wa1hco/Wideband-LNA/Wideband_LNA_TQP3M9037.jpg

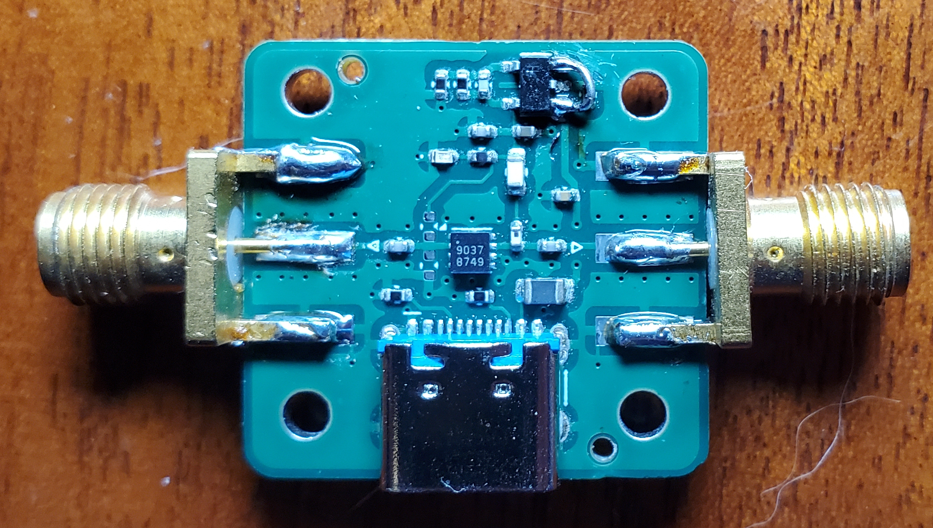
Wideband_LNA_TQP3M9037.jpg
