wa1hco/Wideband-LNA/Wideband LNA board and enclosure.jpg

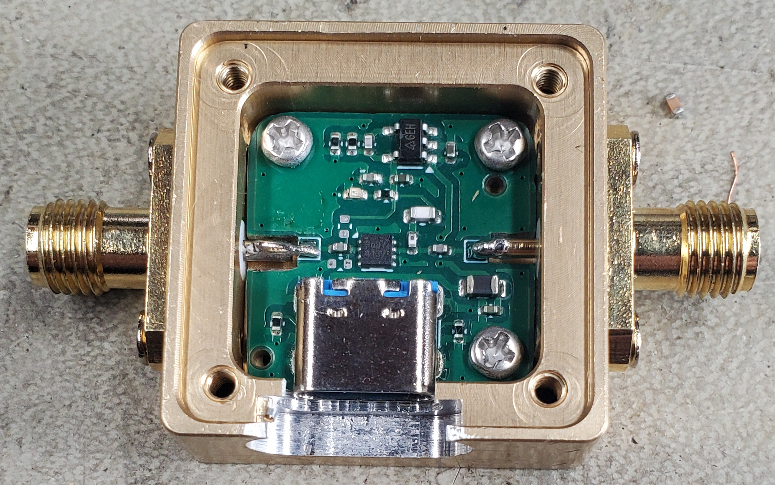
Wideband LNA board and enclosure.jpg
