wa1hco/Wideband-LNA/README.md

# Wideband-LNA
LNA with Qorvo TQP3M9036
~20 dB gain
~0.5 dB noise figure
50 MHz to 2 GHz
~8 dB return loss

Includes bias T option
Power from coax also available on USB-C

Input protection improved with inductor to ground.
