wa1hco/Wideband-LNA/Enclosure_19x19_board.jpg

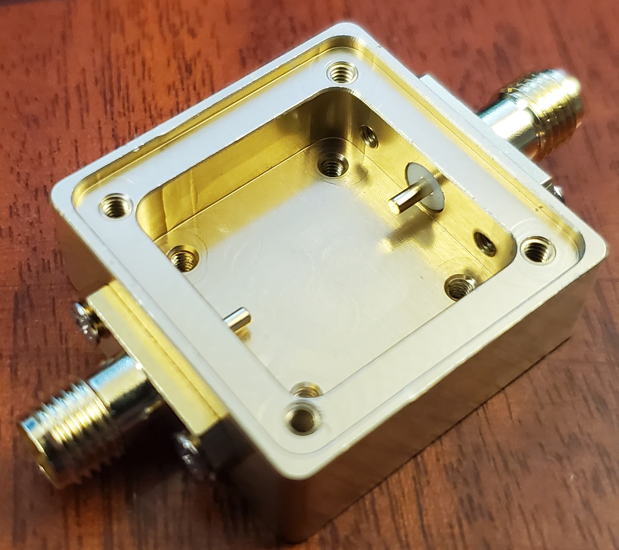
Enclosure_19x19_board.jpg
