wa1hco/Wideband-LNA/test/lna_bench/doc/schematic.png

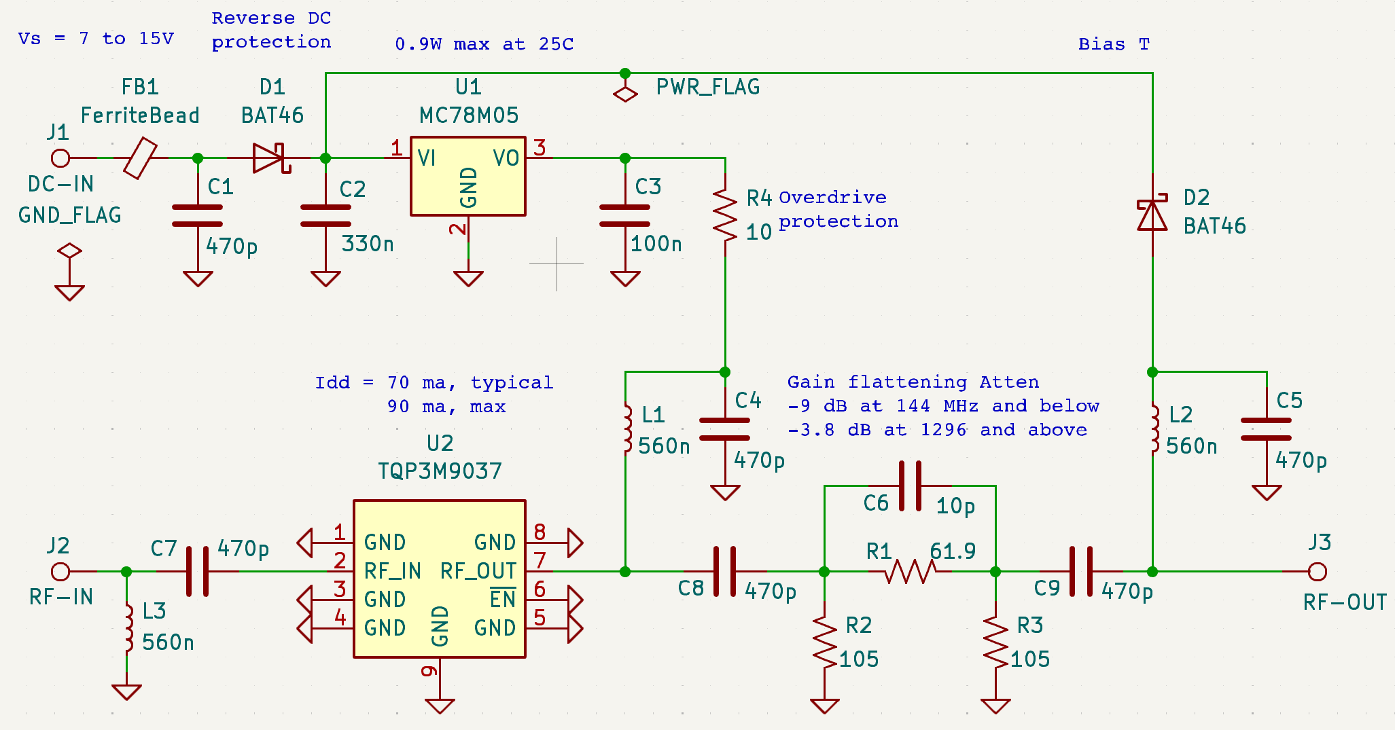
test/lna_bench/doc/schematic.png
