wa1hco/Wideband-LNA/output.pdf

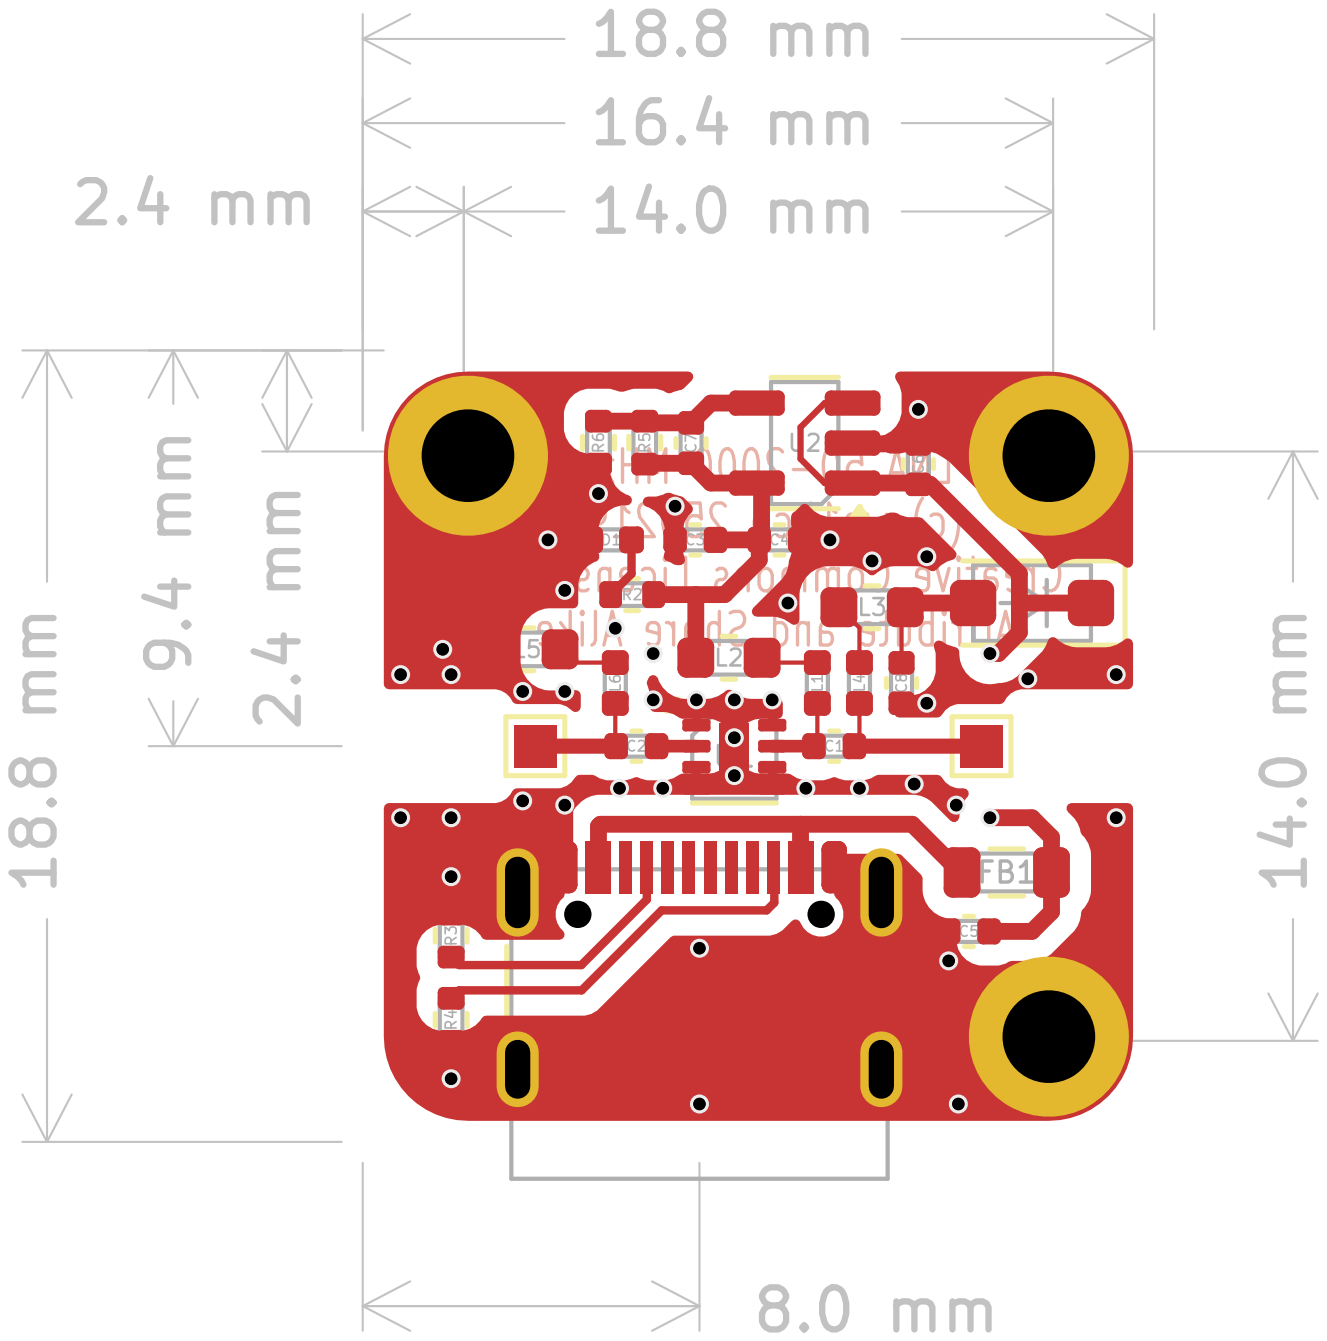
[picture p5: page 1]
