wa1hco/Wideband-LNA/Wideband-LNA.pdf

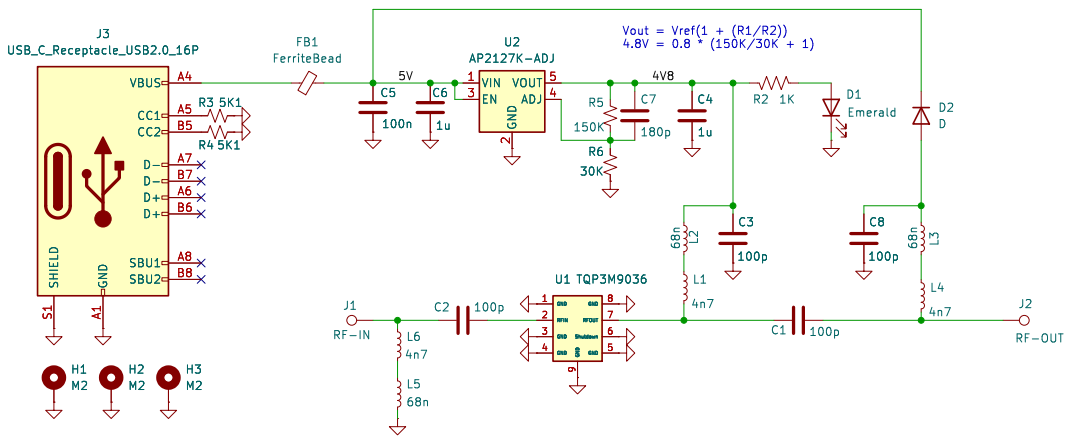
[picture p6: page 1]

2 EN 3 ADJ 4 VOUT 5 U2 AP2127K-ADJ R6
