wa1hco/Wideband-LNA/Wideband-LNA.kicad_pcb

## KiCad design Wideband-LNA.kicad_pcb (2026-05-17)

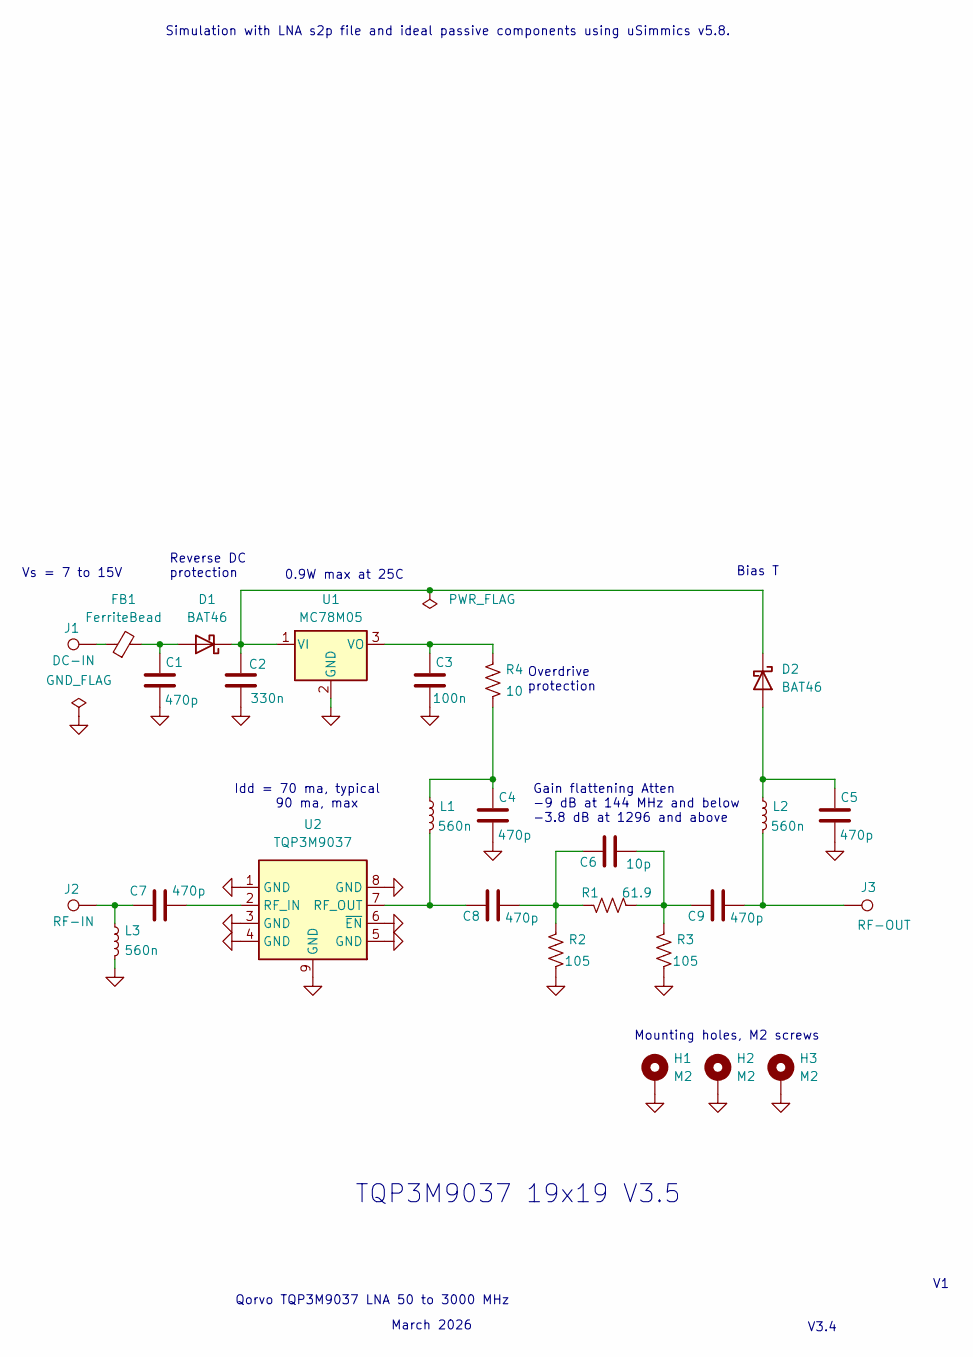
[picture p7: schematic Wideband-LNA.kicad_sch]

Parts:
C1, C4, C5, C7, C8, C9: 470p; C_0402_1005Metric; LCSC C20069335
C2: 330n; C_0402_1005Metric; LCSC C282682
C3: 100n; C_0402_1005Metric; LCSC C1525
C6: 10p; C_0603_1608Metric; LCSC C1634
D1, D2: BAT46; D_SOD-523; LCSC C22466367
FB1: FerriteBead; L_0603_1608Metric; LCSC C1002
H1, H2, H3: M2; MountingHole_2.2mm_M2_DIN965_Pad
J1: DC-IN; TestPoint_Pad_1.0x1.0mm
J2: RF-IN; TestPoint_Pad_1.0x1.0mm
J3: RF-OUT; TestPoint_Pad_1.0x1.0mm
L1, L2, L3: 560n; L_0603_1608Metric; LCSC C6808023
R1: 61.9; R_0603_1608Metric; LCSC C482904
R2, R3: 105; R_0603_1608Metric; LCSC C227541
R4: 10; R_0402_1005Metric; LCSC C25077
U1: MC78M05; TO-252-2; LCSC C94612
U2: TQP3M9037; DFN-8-1EP_2x2mm_P0.5mm_EP0.8x1.6mm; LCSC C415712

Connections:
GND: C1.2, C2.2, C3.2, C4.2, C5.2, H1.1, H2.1, H3.1, L3.2, R2.2, R3.2, U1.2 (GND), U2.1 (GND), U2.3 (GND), U2.4 (GND), U2.5 (GND), U2.6 (~EN), U2.8 (GND), U2.9 (GND)
unnamed: C4.1, L1.1, R4.2
unnamed: C6.1, C8.2, R1.1, R2.1
unnamed: C6.2, C9.1, R1.2, R3.1
unnamed: C7.1, J2.1, L3.1
unnamed: C9.2, J3.1, L2.2
unnamed: C1.1, D1.2 (A), FB1.2
unnamed: C2.1, D1.1 (K), D2.1 (K), U1.1 (VI)
unnamed: C5.1, D2.2 (A), L2.1
unnamed: FB1.1, J1.1
unnamed: C3.1, R4.1, U1.3 (VO)
unnamed: C7.2, U2.2 (RF_IN)
unnamed: C8.1, L1.2, U2.7 (RF_OUT)

Notes on the sheet:
TQP3M9037 19x19 V3.5
Bias T
Mounting holes, M2 screws
March 2026
Reverse DC protection
Gain flattening Atten -9 dB at 144 MHz and below -3.8 dB at 1296 and above
Overdrive protection
Simulation with LNA s2p file and ideal passive components using uSimmics v5.8.
0.9W max at 25C
V3.4
Vs = 7 to 15V
Qorvo TQP3M9037 LNA 50 to 3000 MHz
Idd = 70 ma, typical 90 ma, max

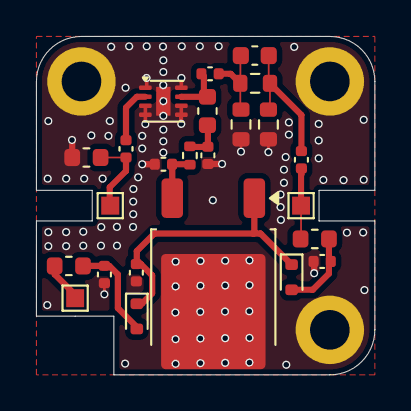
[picture p8: board Wideband-LNA.kicad_pcb from above]

Board: 4 copper layers, 18.8 x 18.8 mm, 27 parts (0 on the bottom side), 13 nets.
