wa1hco/Wideband-LNA/(commit log)

2025-01-16 LNA with Qorvo TQP3M9037, 4 layer board with USB-C power connector.
    [Wideband-LNA.kicad_pcb, Wideband-LNA.kicad_sch, Wideband-LNA.ods]
2025-01-27 rename datasheets, tweak layout
    [Wideband-LNA.kicad_pcb, Wideband-LNA.kicad_sch]
2025-01-27 size to 24x24, tweaked layout
    [Wideband-LNA.kicad_pcb, Wideband-LNA.kicad_sch]
2025-01-27 changed to 50 to 2000 MHz, qorvo 9036, 68 nH choke
    [Wideband-LNA.kicad_pcb, Wideband-LNA.kicad_sch]
2025-01-29 M2 screw hole from via to mounting hole Increased radius of corners Reduced side to 18.8 mm to allow clearance in enclosure Increase size of notch for SMA pin Added into to back silkscreen
    [BOM Priced.ods, Wideband-LNA.kicad_pcb, Wideband-LNA.kicad_sch]
2025-01-31 added SO323 diodes to input for protection. Added experiment for power over coax. Added id and copyright to back silkscreen. changed screw vias to mounting holes reduced size to 18.8 x 18.8 mm for to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
    [Wideband-LNA.kicad_pcb, Wideband-LNA.kicad_sch]
2025-02-13 Added input L to ground and L on output for bias T. Diode to prevent USB-C power from flowing back down coax But allow power from coax to exit from USB-C to power relays, etc.
    [Wideband-LNA.kicad_pcb, Wideband-LNA.kicad_sch]
2025-02-18 Fix input inductor connection.
    [Wideband-LNA.kicad_pcb, Wideband-LNA.kicad_sch]
2025-02-25 added pdfs for board and schematic
    [Wideband-LNA.kicad_pcb, Wideband-LNA.kicad_sch]
2025-03-16 updated design to match input at 144 MHz based on uSimmics modeling added 10 ohm resistor in power lead per suggestion from ZMS
    [Wideband-LNA.kicad_pcb, Wideband-LNA.kicad_sch]
2025-11-22 Update layout to 19x19 enclosure, TQP3M9036 Improved ground via to isolate voltage regulator circuit from input goal of improving stability Add solder mask relief near output to improve contact with 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
    [Wideband-LNA.kicad_pcb, Wideband-LNA.kicad_sch]
2025-12-02 Updated sheet titles to show Version and Git Branch
    [Wideband-LNA.kicad_pcb, Wideband-LNA.kicad_sch]
2025-12-10 Add zone mask to relieve ground plane under component pads
    Added screen shot of JLCPCB impedance calculator
    Removed bias T components
    [Wideband-LNA.kicad_pcb, Wideband-LNA.kicad_sch]
2025-12-14 Preparing for fab and assy
    [Wideband-LNA.kicad_pcb, Wideband-LNA.kicad_sch]
2025-12-16 Added s2p models, simulated with attenuator and flattened gain simulated 9036 and 9037 updated schematic and layout to remove bias T and LED, prep for attenuator
    [Wideband-LNA.kicad_sch]
2025-12-18 Added attenuator with high frequency bypass on output
    [Wideband-LNA.kicad_pcb, Wideband-LNA.kicad_sch]
2025-12-19 Added uSimmics folder and simulations for TQP3M9036 and 9037
    [TQP3m9036.sch, TQP3m9037.sch]
2025-12-22 Updated jlcpcb components
    [TQP3m9037.sch, Wideband-LNA.kicad_pcb, Wideband-LNA.kicad_sch]
2025-12-23 Changed inductors for input antistatic and DC choke
    [TQP3m9037_T.sch, Wideband-LNA.kicad_pcb, Wideband-LNA.kicad_sch]
2025-12-26 added bias T changed from USB-C to feed through
    [Wideband-LNA.kicad_pcb, Wideband-LNA.kicad_sch]
2025-12-30 Optimize layout for 0603 components Change from USB-C to pad for feedthrough capacitor Change regulator to 78L05
    [Wideband-LNA.kicad_pcb, Wideband-LNA.kicad_sch]
2026-01-02 Relayout for 8-32 feedthrough capacitor Relayout for larger DPAK voltage regulator, allows high input voltage Had to remove 10 Ohm series resistor in LNA supply lead Reduced size of ferrite bead to 0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
    [Wideband-LNA.kicad_pcb, Wideband-LNA.kicad_sch]
2026-01-02 Remove stray ground layer mask
    [Wideband-LNA.kicad_pcb]
2026-01-04 Selected components for manufacturing, generated JLCPCB files
    [Wideband-LNA-CuBottom.gbr, Wideband-LNA-CuIn1.gbr, Wideband-LNA-CuIn2.gbr, Wideband-LNA-CuTop.gbr, Wideband-LNA-EdgeCuts.gbr, Wideband-LNA-MaskBottom.gbr, Wideband-LNA-MaskTop.gbr, Wideband-LNA-NPTH.drl]
2026-01-07 Released for production at jlcpcb on Jan 5, 2026 Double checked the jlcpcb tool component selection from LCSC stock
    [Regulator Design.ods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]
2026-05-16 Stop tracking JLCPCB generated files
    [BOM Priced.ods, Regulator Design.ods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]
2026-05-16 catching up, first commit of test code that uses the noise figure meter
    [TQP3m9037.sch]
2026-05-18 lna_bench: port bench settings, add probe_scpi.py, add pytest suite
    - station.example.toml: 10 MHz-3 GHz/401 pts sweep, ham band key
    frequencies (50/144/222/432/903/1296/2304 MHz), 300 s VISA timeout,
    FETC:CORR:NFIG?/GAIN? commands, empty prepare list, INIT:CONT ON
    apply + verify check
    - probe_scpi.py: standalone VISA REPL for bench troubleshooting
    - tests/test_config.py: 8 tests covering all ported settings
    - tests/test_gui.py: 12 tests covering GUI helpers and mock CLI flow
    - cli.py: --notes no longer required (defaults to empty string)
    - transport.py: MockTransport handles FETC:CORR:NFIG?, INIT:CONT?
    [cli.py, probe_scpi.py, transport.py]
2026-05-18 hardware: remove obsolete design docs and update schematic
    [BOM Priced.ods, Regulator Design.ods, Wideband-LNA.kicad_sch, Wideband-LNA.ods]
2026-06-02 bench: deterministic acquisition, single-page report, batch print tools
    Acquisition:
    - Switch broadband sweep to deterministic single-shot via ABOR/INIT/OPC?
    - Direct key-frequency measurement: narrow 1 MHz span, 400 kHz RBW, N=20
    - Push sweep start/stop/points from [sweep] to the instrument
    - Best-effort transport.close() so flaky VISA teardown cannot lose data
    Data:
    - Store measurement_bandwidth_hz and key_point_averages on RunRecord
    (schema migrated via ALTER TABLE)
    - Filter 9.91e37 sentinel values from plot axis math
    - Natural sort by serial ("2" < "10" < "22")
    Report:
    - Compact single-page Letter layout, 0.5" margins
    - Dual-axis NF/Gain plot with key-frequency markers and precise ov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
2026-10-16 Add zero-knowledge UX rule for agents.
    Document the standing owner rule so user-facing flows stay launcher-based, with no env vars, python -m, or CLI flags.
