wa1hco/Wideband-LNA/(notices)

Notices in the files:
Wideband-LNA.kicad_pcb:
Creative Commons License V4
